fehodges/proyecto-iot/docs/detalle-resistencias.png

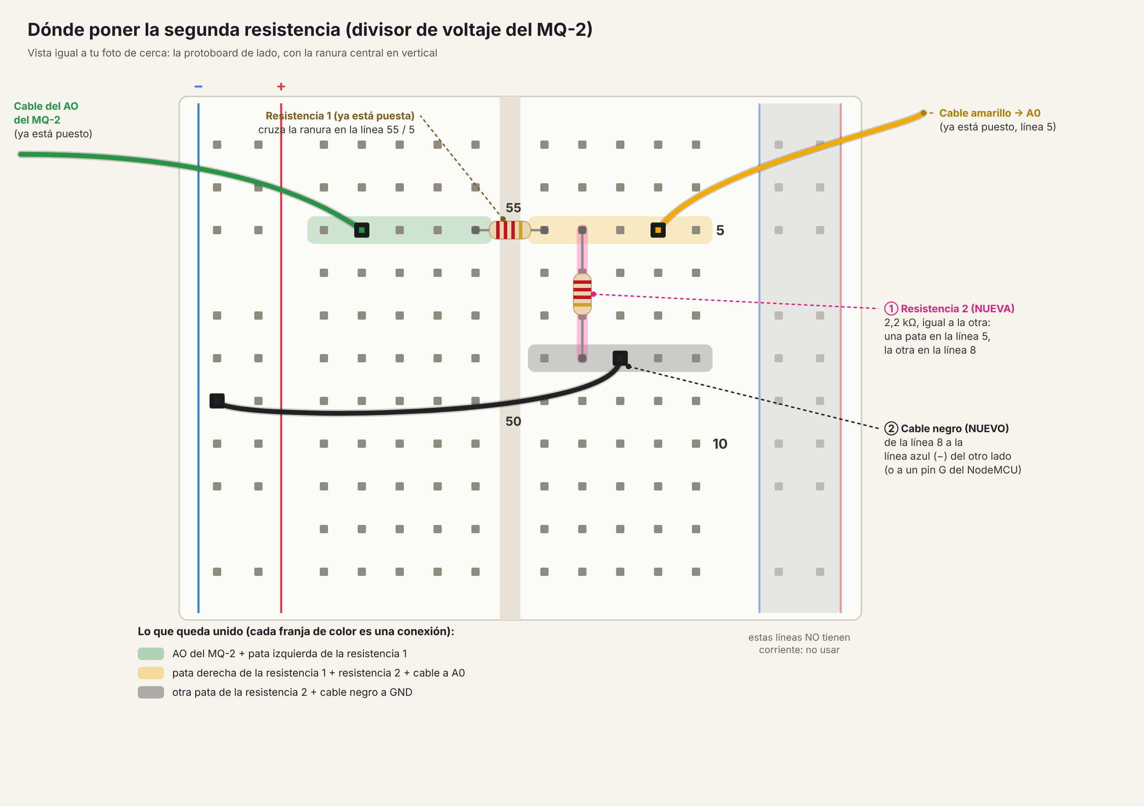
docs/detalle-resistencias.png
