fehodges/proyecto-iot/docs/diagrama-sensores.png

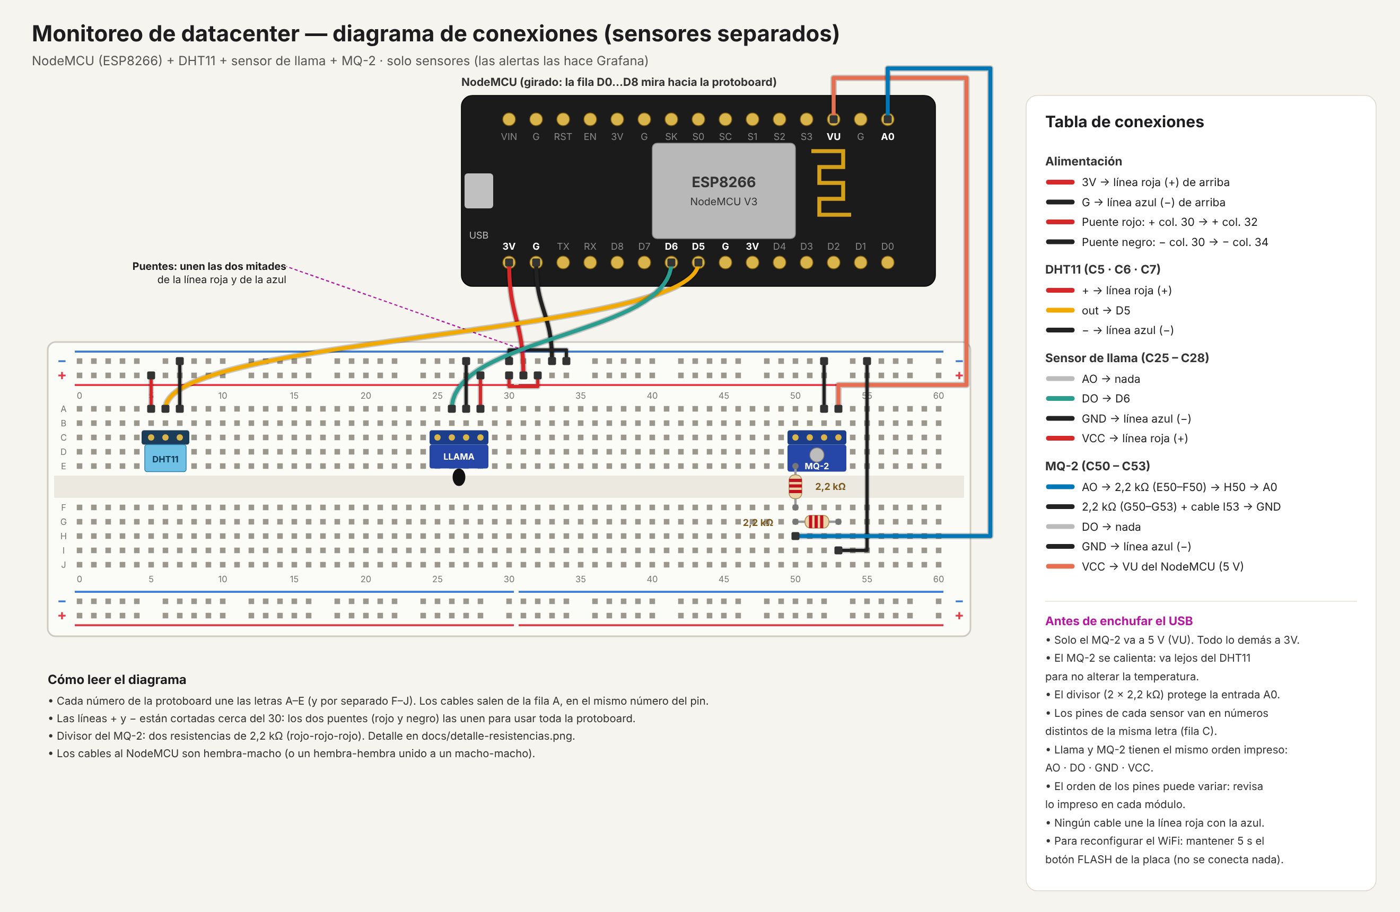
docs/diagrama-sensores.png
