fehodges/proyecto-iot/(commit log)

2026-10-22 Completar proyecto: .env.example, .gitignore, divisor del MQ-2 y orden de pines corregido
    - Agrega .env.example y .gitignore (no se subieron por la web)
    - README y diagrama con el armado final: sensores separados, puentes
    entre mitades y divisor 2 x 2,2 kOhm para el MQ-2
    - Corrige el orden de pines del sensor de llama y del MQ-2 (AO, DO, GND, VCC)
    - simular.sh con permiso de ejecución
    Claude-Session: https://claude.ai/code/session_01AaQspSxJ6PBZKZ4kUrNMzB
    [sensor_datacenter.ino]
2026-10-22 Corrige plantillas de las alertas: $labels y $values sin doble $
    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
